garybethel/DS4toSaturn/(threads)

Thread 1 (2020-01-15):

Emulating on Xbox One

justcallmekoko, 2020-01-15:
This is not really an issue with the library, but I do have a question.

Let's say you want to do the reverse. You have another controller and you want to use that controller on an Xbox One. What would it take to emulate Xbox One controller input on an arduino to function on an Xbox One?
